Charan20510/sign_lang_hud_glasses/docs/handoff/00_project_overview.md

# Project Handoff — Sign-Language → Smart-Glasses HUD (Semester Project)

> Project overview (stable facts). Day-by-day notes live in `YYYY-MM-DD.md` next to this file.
> Paste this whole file into a new chat with: "Continue my project from this handoff. Next I want to: ____"

## 1. Project in one line
ISL signer in front of me → camera → **laptop** (MediaPipe + PyTorch) recognises the sign → word sent over **Wi-Fi** → **ESP32-C3** on my glasses shows it on a **0.96" OLED**, reflected into my eye (DIY HUD). Combined CS + ECE project.

- Me: Charan, final-year B.Tech ECE (VLSI), IIIT Senapati, Manipur. Dev machine: MacBook Air (Apple Silicon).
- **Ownership (from 2026-10-31):** Charan = hardware + firmware (branch `testout`); friend = all software (branch `S1`). Shared contract: `docs/interface.md`.
- **Since 2026-11-01:** friend's app imported into `software/` on branch `software` (from github.com/integral-830/sign-inference-bridge); it sends every word + sentence to the glasses over UDP.
- Style: short, simple key points.
- Scope: **isolated words** (INCLUDE-50 + my own words), not full sentences.

## 2. Final architecture
```
[Camera: laptop webcam (now) / ESP32-CAM on glasses (stretch)]
   → [Laptop: software/run.py — MediaPipe landmarks → TCN model → sentence builder → (English)]
   → UDP JSON {"text","conf"} to glasses.local:4210 over phone hotspot (software/glasses.py)
   → [ESP32-C3 SuperMini + SSD1306 OLED (firmware/glasses_display) → 25mm lens → 45° acrylic → eye]
```

## 3. Optics design (side view, cm, internal) — drawn in hud_glasses_drawings.pdf
- **Update 2026-10-31 (enclosure v3.1):** mirror dropped; OLED sits 22 mm from the lens (bench value, ±3 mm focus slots). Numbers below are the original design.
- OLED → mirror (45°): **2.2** | mirror → lens: **1.8** | total u = **4.0 cm** < f = 4.5 cm
- Lens → acrylic (45°): **1.5** | eye relief ≈ **2.0**
- Result: virtual image ≈ 36–38 cm away, ~9× magnified.
- Housing: total length **9.5**, optics head **2.5**, electronics tube **7.0**, height **3.0**, internal width **2.9**, head drops to **6.0**.
- Panels: side ×2 (L-shape 9.5×6.0), top 9.5×2.9, bottom 7.0×2.9, front 3.3×2.9, rear 3.0×2.9 (2 USB-C cut-outs 0.9×0.35), lens plate 2.5×2.9 (hole Ø2.4), mirror 2.5×2.9, acrylic 3.0×2.9, step strip 0.3×2.9.
- Notes: paint interior matte black; thin acrylic (1 mm) avoids double image; text may be flipped → fix in code (setRotation / mirror commands); focus by sliding OLED ±3 mm.
- Based on github.com/perseus784/June_Glasses (concept/optics only; its electronics had flaws: no regulator, ESP8266-01, hardcoded IP).

## 4. Electronics & wiring
**Display unit (glasses):**
- LiPo #1 → TP4056 #1 (B+/B−) → OUT+ → slide switch → ESP32-C3 **5V** pin; OUT− → GND
- ESP32-C3 → OLED: 3V3→VCC, GND→GND, **GPIO8→SDA, GPIO9→SCL**, I2C addr 0x3C

**Camera unit (stretch, opposite arm):**
- LiPo #2 → TP4056 #2 → switch → **MT3608 set to 5.0 V** → ESP32-CAM 5V/GND
- Never feed LiPo directly to ESP32-CAM. Runs hot; ~1 h on 600 mAh.

**Safety / charging (decided 2026-10-29):** TP4056 left stock (1 A = 1.7C for 600 mAh) → its USB is NEVER used with a cell attached (port taped "NO USB"). Charge only with the lab bench supply: 4.20 V CV, 0.30 A limit, stop at ≤ 0.05 A. Battery leads soldered to B+/B−, never hand-held.

## 5. Parts status (as of 24 Oct 2026)
**In hand (Robocraze order 377900, delivered):** ESP32-C3 SuperMini ×2 (unsoldered), 0.96" SSD1306 OLED ×2,
TP4056 Type-C w/ protection ×2, slide switch ×3, veroboard 6×4 ×2, 40×2 male + 40×1 female berg,
Type-C cable, MB102 830 breadboard, jumper wire set, 12-in-1 soldering kit (with multimeter).

**Arrived by 2026-10-29:** LiPo 3.7 V **600 mAh** ×2 (KP 602030P, ~30 × 20 × 6 mm), DOMO 25 mm / f45 lens pair, 1 mm acrylic ×4.
**Still to get:** mirror 25 × 30 mm (local shop), heat-shrink/tape.
**Stretch, not ordered yet:** ESP32-CAM OV3660, ESP32-CAM-MB, MT3608 boost, glue gun.

**Local / already have:**
- Mirror piece 2.5×2.9 cm — local glass shop (₹10–30), thin glass preferred
- Glasses frame — my Lenskart computer glasses (mount with zip ties/velcro, no glue; raise OLED contrast because of blue-cut coating)

## 6. Software (`software/`, branch `software`; friend's code)
- `python software/run.py --port 9000` → camera + model + HTTP server (phone) + **UDP to the glasses (default)**.
  `--glasses <IP>` if `glasses.local` fails, `--no-glasses` to turn it off, `--simulate` = fake signer (no camera/model).
- `software/glasses.py` = UDP sender (`{"text","conf"}`, < 256 bytes, host/port from `config.yaml`); self-check: `python software/glasses.py`.
- Live run sends each signed word, each spelled word, then the finished sentence (English if `--translate`).
- Model: `software/model/sign_model.pt` (words, TCN). Training/datasets: `software/RUNBOOK.md`.
- Root `venv/` has torch, mediapipe, opencv, numpy, pyyaml. Camera preview: 1280×720 + preview-only white balance.
- Step-by-step: `docs/run_guide.md`. Manual link test: `tools/send_test.py`.

## 7. Files created so far
- `CLAUDE.md` — Claude Code project spec (hardware side, rules; gitignored)
- `docs/interface.md` — app ↔ glasses contract
- `docs/run_guide.md` — flash → link test → simulate → live camera
- `firmware/glasses_display/glasses_display.ino` — final receiver: centred size-2 words; sentence scrolls 2× (60 px/s) then blank
- `software/` — recognizer app (run.py, live_demo.py, glasses.py, RUNBOOK.md)
- `hud_glasses_drawings.pdf` + 2 PNGs — side view with dimensions, optics math, wiring diagram, cut templates

## 8. Open to-dos
1. Hardware bring-up (`docs/hardware_bringup.md`): Steps 1–11 ✅ (2026-10-31). Next: 12 optics bench + measurements → 13 soldering → 14 enclosure print (`hardware/enclosure`).
2. LiPos: charge only on the bench supply (4.20 V, 0.30 A, stop ≤ 0.05 A).
3. glasses_display: NO LINK after 10 s + Wi-Fi auto-reconnect.
4. Latency measurement (packet in → OLED update) for the report.
5. Tell friend about `software/`; agree any packet change via `docs/interface.md`; decide when to merge `software` → `testout`/`main`.
6. Later: camera unit (ESP32-CAM), report & viva prep.

Daily log: see `docs/handoff/README.md`.
