Charan20510/sign_lang_hud_glasses/docs/handoff/2026-11-01.md

# 2026-11-01

Branch: `software` (on top of `testout`). Pushed to GitHub: `software` → `origin/main`, plus `testout`.

## Done
- **Run guide** `docs/run_guide.md`: flash glasses_display → `send_test.py` → `run.py --simulate` → live camera, + troubleshooting.
- **Link works end to end:** `send_test.py` → glasses at 10.249.236.231; `run.py --simulate --port 9000` → words + sentences on the OLED.
- **Final receiver** `firmware/glasses_display/glasses_display.ino` (from t4 Wi-Fi/UDP + t6 centring):
  - word that fits (≤ 10 chars) → centred, text size 2;
  - longer text (sentence) → one line, size 2, scrolls right-to-left at `SCROLL_PX_PER_S` 60, `SCROLL_PASSES` 2 times, then blank;
  - `MIRROR_X` / `FLIP_Y` = 0; `secrets.h` copied from t4 (gitignored). Compiles: 79 % flash.
- **Simulation** (`run.py --simulate`): English words one by one, `WORD_GAP_S` 2 s apart, then the sentence;
  waits `SCROLL_PASSES × scroll_seconds()` so both passes finish (measured 14.6 s gap for "I am going to school.").
- **Live camera run works** with `software/model/sign_model.pt` (words model, TCN); venv now has torch 2.15, mediapipe 0.10.35, opencv 4.11.
- **Camera preview:** opens at 1280×720 (was 640×480, blurry); preview-only gray-world `white_balance()` removes the yellow cast of the warm room light (recognition uses the raw frame).
- **Rosetta 2 installed:** Arduino's `ctags` is x86_64 → "bad CPU type in executable" fixed.
- **Root `README.md`:** how it works, status, BOM, wiring, enclosure gallery + STL links, step-by-step setup,
  interface, config, troubleshooting, layout, credits (friend's software → integral-830/sign-inference-bridge).
  New images in `docs/images/`: `system.svg`, `wiring.svg`, `assembly_eye_side.png` (OpenSCAD inside view).
  `<!-- PHOTO: ... -->` slots mark where real photos go.
- **Pushed to GitHub** (github.com/Charan20510/sign_lang_hud_glasses, public): `software` → `main` (fast-forward), `testout`.
  Secret scan first: no `secrets.h`, `.env`, keys or the real hotspot name/password in any commit. `S1` not pushed.

- **Project report** `docs/report/main.tex` (+ `main.pdf`, 32 pages) in the IIIT Manipur B.Tech template:
  US Letter, 0.8/1 in margins, Times New Roman 12 pt, template header + `Page N` footer, same page order and
  all 7 chapters / 30 sections (checked by script). Figures: TikZ (system, optics, workflow, wiring, firmware
  flowchart, scroll-time graph) + OpenSCAD renders; logo cropped from the template PDF. Placeholders left for
  name, roll no, advisor, month/year (`\newcommand`s at the top). Build: `cd docs/report && tectonic main.tex`.

- **Report restructured as a group project** (`docs/report/main.tex`, 36 pages): Ayush Verma (230102017) +
  Charan Tej (230104002), supervisor Dr. B. Somaraju, Project II (EC4201), 7th sem, Nov 2026. Format now follows
  the department's Major Project Report (A4, 1.5 spacing, roman front matter, CHAPTER N, 5 chapters + Appendices A-D,
  abbreviations + symbols lists). All internship text removed (0 hits). Change log: `docs/report/report_changes.pdf`
  (Space Mono 12px, from `changes.html`, built by `docs/guide/build_pdf.sh`).

- **README engineering drawings:** 6 hand-drawn-style SVG sheets in `docs/images/drawings/` (side view to scale,
  optics ray diagram, wiring, clip mount, printed parts, OLED screens) from `make_drawings.py`; values from
  `hud_enclosure.scad` + its echo, STL bounding boxes, bench measurements. Old concept sheets kept as
  `docs/drawings/hud_glasses_drawings_v1.pdf` (superseded). README: new section + sheets under How it works / Wiring.

## Issues
- `glasses.local` (mDNS) sometimes not found from the Mac → use `--glasses 10.249.236.231` (IP shown on the OLED).
- Port 8000 is held by the HUNT project's uvicorn → run with `--port 9000`.
- glasses_display has no NO LINK screen or Wi-Fi auto-reconnect yet (CLAUDE.md §5 asks for both).
- Simulation shows English words; the live run shows only signed glosses (ISL has no sign for "is", so TODAY HOT ≠ IT IS HOT TODAY).
- git `user.name` is set to `--all` → commits use `git -c user.name=Charan20510`.

## Fixes
- Sim used ISL glosses (only TODAY / HOT appeared) → sim now splits the English sentence into words.
- Cramped 4-line word-wrap for sentences → replaced by a one-line scroll; `wrap()` removed.
- `download_models.py` must run from `software/` so models land in `software/mp_models/`.

## Next
- glasses_display: NO LINK after 10 s without a packet (keep last text?) + Wi-Fi auto-reconnect.
- Measure glasses-side latency (packet in → OLED update) for the report.
- Tell the friend the app now lives in `software/` (their HTTP/phone path is untouched; `esp/` sketches dropped).
- `main` now equals `software`; decide whether `testout` should catch up too.
- Take photos (breadboard, soldered unit, printed enclosure, glasses worn) → `docs/images/`, replace the README `PHOTO` comments.
- Report: confirm course code EC4201, date and work division (Ayush = software); add real photos (commented slots in ch. 4).
- Tell the friend their code is public in this repo (credited in the README).
- Hardware: Step 12 optics bench + measurements → enclosure print.

## Commits
- 00:07 `8c8613a` Add run guide: app to ESP32 Wi-Fi to OLED
- 00:21 `e57b8ba` glasses_display: centred size-2 words; simulate English words 2 s apart
- 10:54 `074ead4` glasses_display: scroll the full sentence horizontally; sim waits one pass
- 11:21 `8340ac4` Camera preview: 720p capture and preview-only white balance
- 12:05 `82cfd81` glasses_display: scroll sentence 2 times then blank screen
- 12:16 `d227a04` Handoff: sync day logs and project overview to end of 2026-11-01
- 12:25 `1893378` Add t6_mirror_center test sketch; handoff log entry
- 12:29 `06ae0ae` README: project overview, diagrams, enclosure renders, setup guide
- 12:29 `b407f08` Handoff: README and GitHub push notes
- 12:30 `4ead668` Handoff: branch line and commit log
- 12:54 `adc36bd` Project report in LaTeX (IIIT Manipur template) with figures
- 12:54 `e27fc8e` Handoff: project report notes
- 13:26 `35e1088` Report: restructure as group project (Project II, EC4201) + Space Mono change log
