Charan20510/sign_lang_hud_glasses/docs/handoff/2026-10-31.md

# 2026-10-31

Branch: testout

## Done
- Bring-up Steps 1–11 all done (Charan): guide stamps ✅ on Steps 7–11, checklist rows ticked, `docs/hardware_bringup.md` Results rows 1–16 ✅ (readings not recorded).
- Step 12 fill-in sheet: `docs/step12_measure.pdf` (2 pages, source `docs/guide/step12_measure.html`, built by `build_pdf.sh`).
- Bench result: OLED → lens **22 mm** is sharp (design had 40 mm with f = 45); lens → acrylic 34 mm worked, model keeps 16 mm.
- **Enclosure v3** (`hardware/enclosure/hud_enclosure.scad`): mirror removed; OLED lies flat, screen down, 22 mm above the lens, held by side-wall rails (glass-free strips only) with slots at u = 19 / 22 / 25; head 30 mm long; lens plate moved to 6 mm below the tube floor (eye 21 mm below the tube); new `section` preview. Pockets, lid clicks, fingers, dovetail + clip kept. All parts render clean, asserts pass.
- README rewritten for v3 with step-by-step "how to view the 3D model" (OpenSCAD Customizer `part`, F5/F6, mouse, views, Quick Look).
- Step 12 in guide, md and the fill-in sheet switched to the no-mirror path (u = 22, focus check O5). PDFs rebuilt.
- Glasses measured: temple arm 7 × 7, dv = +10, dh = 37, rim = 13.
- **Enclosure v3.1 (print-ready):** lens → acrylic **25 mm** (`drop` 43, eye 30 mm below tube); glasses entered as raw values (`temple_w/h`, `temple_dv`, `temple_dh`, `frame_rim`) and clip derived (jaw_drop 35, jaw_out 12.5, strain 2.2 % with `jaw_lip` 0.45); rim clears tube by 14.6; new `plate` part → `stl/print_all.stl` (all 4 parts on one bed, 137 × 161 mm). Step 12 docs + sheet updated (25 mm, raw values).
- Print estimate: ~73 g PLA, ~6 h normal / ~2.5 h fast printer (body 50 g, lid 16, clip 5, lens plate 2); `test_fit` optional 27 g.

- **Re-scope to hardware only:** software is my friend's part (branch `S1`). On `testout` removed `ml/`, `app/`, `tools/record_custom.py`, `tools/data_summary.py`, `tests/test_normalize.py`, `reports/`, and the obsolete mirror order sheet (`docs/mirror_order.*`, `docs/guide/mirror_order.html`). `config.yaml` trimmed to `network:`; `requirements.txt` → `pyyaml`, `pytest`; `data.zip` gitignored.
- Cleanup (local only, to Trash): all `.DS_Store`, `files/PROJECT_HANDOFF.md` (old overview duplicate), `.pytest_cache/`, old 1.4 GB `venv/`. Rebuilt `venv/` with only `pyyaml` + `pytest` (42 MB).
- Removed `tests/test_send_test.py` and `pytest` (not needed for hardware). Kept `config.yaml` (read by `send_test.py`) and `scripts/` (post-commit hook fills the Commits list).
- New `docs/interface.md`: UDP 4210, `{"text","conf"}` JSON < 256 bytes, `glasses.local`, NO LINK 10 s. CLAUDE.md rewritten for the hardware side; overview §1/§6 updated.
- Branch `software` (off testout): friend's app imported into `software/` (no esp/, no .git). `software/glasses.py` sends each word + sentence over UDP to glasses.local:4210; `run.py` does it by default. Verified: self-check OK, `run.py --simulate --glasses 127.0.0.1` → packets ME / SCHOOL / GO / "I am going to school."
- `~/Downloads/sign-inference-bridge` moved to Trash (git was clean + pushed to integral-830/sign-inference-bridge).

## Issues
- Step 7–11 readings (B+ volts, runtime hours, …) not written down; only ✅.
- u = 22 doesn't match the lens's marked f = 45 (theory → image ~10 cm from the eye). Real f probably ~25 mm.
- Mirror no longer used; `docs/mirror_order.*` sheet is obsolete (removed in the re-scope).
- `CLAUDE.md` is gitignored, so its rewrite stays local only.
- `data.zip` (12 GB) and `data/` (12 GB) were the friend's ML data; friend has a copy, both moved to macOS Trash (empty Trash to free ~24 GB).
- Glasses show NO LINK after 10 s idle: the app sends only when a word/sentence happens (no keep-alive in the contract).
- Full live run (camera + model) not tested here: root venv has only pyyaml; needs `pip install -r software/requirements.txt` + trained model.

## Fixes
- Design follows the bench value (`d_oled_lens = 22`) with ±3 mm focus slots instead of f = 45 math.
- OLED PCB (27.3) is narrower than the 29 mm inside → rails reach in 2.5 mm and grip only the glass-free front/rear strips.

## Next
- Print `hardware/enclosure/stl/print_all.stl` (black PLA, 0.2 mm, 3 walls, 20 %, no supports); optional `test_fit.stl` first.
- Still unmeasured (defaults): board sizes, OLED glass start/end (`oled_glass_x`), lens thickness, lens real f.
- Bend OLED header pins flat toward the rear (3.5 mm room above the PCB) or solder wires directly.
- Uncommitted: enclosure v2→v3.1, Step 12 sheet, mirror order sheet, `t3_oled_hello` MIRROR_X 0.
- `firmware/glasses_display/` is still empty; write the receiver, then `python software/run.py --simulate` against real glasses.
- Tell friend the app now lives in `software/` (their HTTP/ESP path untouched; `esp/` sketches dropped).

## Commits
- 14:46 `943764b` Enclosure v3.1: no mirror, measured glasses, print-ready plate
- 16:07 `1fc3abe` Re-scope repo to hardware/firmware; software moved to friend (S1)
- 16:10 `02a4b76` Handoff: dataset removed from laptop (friend has copy)
- 17:38 `63a4b4e` Handoff: local cleanup, small venv
- 17:41 `2aa1bf3` Remove packet test and pytest; keep config + hooks
- 23:55 `0ecd47a` Import recognizer app into software/ and send words to glasses over UDP
