Charan20510/sign_lang_hud_glasses/docs/handoff/2026-10-30.md

# 2026-10-30

Branch: testout

## Done
- Enclosure v2 built (`hardware/enclosure/hud_enclosure.scad`):
  - pockets for LiPo, TP4056, ESP32-C3 and the switch, with engraved labels;
  - lid clicks shut with 3 bumps, and 2 lid fingers hold the boards down;
  - `side = "right"`, which mirrors the parts for the right eye;
  - female dovetail slot in the temple-side wall (now 4 mm thick) + new swappable `clip` part that snaps onto the temple arm.
- `lipo` set to the real 600 mAh 602030 (30 × 20 × 6). TP4056 USB-C hole replaced by a Ø3.5 charge-lead exit (bench-supply charging).
- `build.sh` exports body, lid, lens_plate, clip and test_fit: all clean, all asserts pass. README rewritten for v2.

## Issues
- Planned snap hooks for the boards would crack: 1.2 × ~3.5 mm cantilever, 0.5 mm bend ≈ 7 % strain vs PLA ~2–3 %. Board edges also carry pins and pads.
- Possible frame clash: tube floor is ~15 mm above the acrylic centre; a tall glasses rim may hit it.

## Fixes
- Boards held by 3-sided pockets + lid fingers on the USB-C shells instead of hooks.
- Clip jaw sized by a strain check (`jaw_t` 1.6, `jaw_lip` 0.5 → 1.9 %); the render fails above 2.5 %.

## Next
- Measure the temple arm (`temple_w`, `temple_h`, `jaw_out`, `jaw_drop`), plus the boards, switch and mirror. Update the `MEASURE` variables → `sh hardware/enclosure/build.sh`.
- Print `test_fit.stl`: tune `clr`, `dt_clr` and `jaw_grip`. Hold the clip on the glasses to check the frame-rim clearance.
- Then print body, lid, lens plate and clip in matte black.
- Bring-up: insulate battery joints, tape the TP4056 USB, Step 7 USB-only test, Step 11 leftovers.

## Commits
- 14:55 `f70fc3c` Bring-up: Step 10 runs on battery (READY + IP, 5V pin 3.967 V)
