Charan20510/sign_lang_hud_glasses/docs/handoff/2026-10-29.md

# 2026-10-29

Branch: testout

## Done
- 3D-printed enclosure for the display unit: `hardware/enclosure/hud_enclosure.scad` (OpenSCAD, parametric) + `build.sh`.
- Exported `stl/body.stl`, `lid.stl`, `lens_plate.stl`, `test_fit.stl` + PNG previews; README with cut list, print settings, assembly.
- Installed OpenSCAD (`brew install --cask openscad@snapshot`; stable cask is disabled by Homebrew).
- Planned enclosure v2 (snug pockets + clip-on mount); not built yet, plan below.

## Issues
- Drawing's lens→acrylic 15 mm makes the 30 mm acrylic hit the lens plate.

## Fixes
- Lens→acrylic set to 16 mm (`d_lens_acr`); focus depends only on u = 40 mm, unchanged.

## Next — enclosure v2 (pockets + clip-on)
Resume: say "continue enclosure v2 from today's handoff".
Choices made: swappable clip on a dovetail, snug pockets + snap hooks, right eye.
Files: `hardware/enclosure/hud_enclosure.scad`, `build.sh`, `README.md`. Reuse `box()`, `usb_cut()`, asserts, part selector.

0. **Measure first:** temple arm width × height where the clip goes (`temple_w`, `temple_h`); LiPo, TP4056, ESP32-C3, OLED, mirror thickness.
1. **Right-eye side fix:** wearer's right = +y = lid side in v1, but the body wall must face the temple.
   Add `side = "right"`; wrap body/lid/lens_plate in `mirror([0,1,0])` when right; counter-mirror labels so text reads.
2. **Pockets (replace bare shelves + foam tape):**
   - LiPo floor cradle: rim walls 1.2 thick × 4 high on the front and lid side; the TP tray above caps it.
   - TP4056 + ESP32 trays: 3-side rim 1.0 high (front stop, body side, rear = wall). The lid-side edge gets a snap hook
     (cantilever 1.2 thick, 0.5 overhang, 45° lead-in); press the board down and it clicks under the hook.
   - Raise ESP tray: `s2 = s1 + shelf_t + tp_h + 3.0` (room to press the TP4056 past its hook).
   - Switch: press-fit cradle under the top slot (`sw_body = [8.6, 3.6, 3.6]`, 0.1 interference).
   - Labels cut 0.4 deep, 3 mm font: LiPo, TP4056, ESP32, SW. OLED comb unchanged; keep the wire gap on the lid side.
3. **Lid without zip ties:** 0.4 bumps on the lid lip bars, 0.6 dimples in the body walls → clicks shut. `tie_grooves_on = false` by default.
4. **Clip-on mount:**
   - Body side wall `side_t = 4` (was 2.4), body only.
   - Female dovetail slot in the outer face of the body side wall, along x on the tube (x 50..80, mid-height):
     mouth 6, inner 9, depth 2.5, open at the rear end, stop at the front end, 0.4 detent bump. Prints fine on the bed face (27° walls, 9 mm bridge).
   - New part `clip` = `linear_extrude(25)` of one 2D profile (prints on its side, no supports):
     male dovetail (−0.2 clearance) → arm (`jaw_drop`, `jaw_out`) → C-jaw around `temple_w × temple_h`,
     wall 2, bottom opening with 0.8 lips, 0.3 interference grip, dimple for the detent.
   - New glasses = change `temple_w/temple_h` (+ `jaw_drop/jaw_out`), reprint only `clip.stl` (~10 min).
5. **Checks / outputs:**
   - Asserts: pockets inside the cavity, hooks clear of the lid lip, slot depth < `side_t` − 1, slot clear of the USB/switch cut-outs, jaw opening < `temple_w`, ESP USB-C pocket ≤ H.
   - `test_fit`: add the TP tray with hook, a 30 mm slot segment, and the clip. `build.sh`: add `clip` to the part loop.
   - README: measure the temple, swap-clip steps, new assembly order (no tape or ties). Update the handoff log.
   - Done = `sh hardware/enclosure/build.sh` runs clean, previews show pockets, slot and clip. Don't change optics distances/comb, firmware or ml. Don't commit unless asked.

Still open from v1: get the mirror cut to 25 × 30 mm and the acrylic to 30 × 30 mm; print `test_fit.stl` at the college lab and tune `clr`.

## Bring-up (Step 7)
### Done
- LiPo ×2 (600 mAh, KP 602030P), 25 mm lens and 1 mm acrylic arrived.
- Rewrote the bring-up guide to 15 steps (`docs/guide/bringup.html` → `docs/hardware_bringup.pdf`, 17 pages; `docs/hardware_bringup.md` matched):
  7 chargers USB-only, 8 R3 mod (new), 9 battery leads + first charge (new), 10 ESP32 on battery + runtime (new),
  11 leftover checks, 12 optics bench test (new), 13 soldering, 14 enclosure, 15 checklist (synced with md results).

### Issues
- Step 7: LiPo put on TP4056 #1 with wires held by hand; red LED = charging at ~1 A (R3 still stock 1.2 kΩ = 1.7C for 600 mAh).
- Cells are 600 mAh / ~30 × 20 × 6 mm, not the planned 500 mAh / 35 × 26 × 7 (`lipo` size in `hardware/enclosure/README.md` + scad is stale).

### Fixes
- Told to unplug, remove the cell, check it for heat/swelling. Guide now blocks any LiPo until the R3 mod (Step 8) and requires soldered leads (Step 9).

### Next
- Step 7 USB-only B+ readings + switch beeps → buy 2.2–2.4 kΩ ×2 → Step 8 R3 mod → Step 9.
- Optics Step 12 can start now without the mirror (lens + acrylic only).
- Enclosure v2: update the `lipo` pocket to the real cell size (measure it).

## Bring-up (charging decision)
### Done
- LiPo #1 measured 3.999 V (Rigol DM3058E) → ~80 %, no charge needed now.
- Decision: no R3 mod, no new charger. Charge on the lab bench supply (4.20 V CV, 0.30 A limit, stop ≤ 0.05 A). TP4056 stays stock, its USB is taped "NO USB" once a cell is soldered.
- Guide updated: Step 8 = bench-supply charging (R3 mod kept as an optional note), Step 9 = solder leads + NO-USB tape, Step 10 wake/recharge via bench supply, checklist rows 11–16. PDF rebuilt (17 pages), md matched.

### Next
- Step 7 (TP4056 USB-only B+ test, no battery, + switch beeps) → Step 9 (solder LiPo, tape USB) → Step 10 (ESP32 on battery + runtime).
- Charge only when a cell drops to ~3.5–3.9 V.

## Bring-up (Step 10 on battery)
### Done
- Battery → TP4056 B+/B− → OUT+ → slide switch → ESP32-C3 5V, OUT− → G. OLED showed `READY` + 10.249.236.231 on battery; words from `send_test.py` appeared.
- 5V pin = 3.967 V under load (battery was 3.999 V unloaded) — expected, the 5V pin is the battery voltage on battery.
- Slide switch: 2 end tabs are mounting only (noted in the guide).

### Issues
- Battery-to-extension-wire joints are bare (short risk). Dim red LED on the TP4056 with no USB (leakage, harmless).

### Next
- Insulate the battery joints, tape the TP4056 USB "NO USB".
- Measure ESP32 3V3 (≈ 3.3 V), switch OFF/ON test, runtime test.
- Step 7 USB-only B+ test (no battery), then Step 11 leftovers.

## Commits
- 13:28 `c196fae` Enclosure: parametric OpenSCAD model, STLs, print + assembly guide
- 13:48 `cbd6379` Handoff: enclosure v2 plan (pockets + clip-on mount)
- 18:29 `76ddb17` Bring-up guide: 15 steps, bench-supply LiPo charging
