Charan20510/sign_lang_hud_glasses/docs/handoff/2026-10-26.md

# 2026-10-26

Branch: testout

## Done
- Logged bring-up results Steps 3–6 (see 2026-10-25); docs, CLAUDE.md tips and memory updated.

## Issues

## Fixes

## Next
- Step 6 extras: `python tools/send_test.py --text hello` (glasses.local) and `echo -n "hi" | nc -u -w1 <IP> 4210`.
- Step 7: TP4056 #1/#2 B+ ≈ 4.2 V on USB only; slide switches ×3 continuity.
- TP4056 R3 mod (~2.4 kΩ) BEFORE any LiPo.
- ESP32-C3 #2 blink, OLED #2 scan + HELLO, MIRROR_X test.

## Commits
- 16:59 `310b429` Bring-up: steps 3–6 results, docs update
