Charan20510/sign_lang_hud_glasses/docs/handoff/2026-10-24.md

# 2026-10-24

Branch: testout

## Done
- Robocraze order received + breadboard, soldering kit, jumper wires (see overview §5).
- Committed `.gitkeep` cleanup on S1; created branch `testout` for hardware bring-up.
- Moved handoff from `files/` (gitignored) to tracked `docs/handoff/`; dated daily log + post-commit hook.
- Wrote `docs/hardware_bringup.md`, test sketches in `firmware/tests/`, `tools/send_test.py`.
- Step 1 ✅ both ESP32-C3: 5V pin = 5.162 V, 3V3 pin = 3.302 V (Rigol DM3058E bench meter).
- Decision: no soldering until final build; all tests on breadboard with friction-fit headers. Guide Step 2 rewritten, soldering moved to "Final build" section.
- Made printable guide `docs/hardware_bringup.pdf` (11 pages, A4, Space Mono 12px, drawn SVG diagram per step) from `docs/guide/bringup.html` via Chrome headless.

## Issues
- Global git `user.name` is `--all` (broken). Commits made with `git -c user.name=Charan20510`.
- `arduino-cli` not installed yet.
- Meter read ~0 V (red lead in the 10A jack).
- PDF symbols (✅ ☐ ⚠ →) render in Menlo: Space Mono has no such glyphs. Text itself is Space Mono.

## Fixes
- Meter: red lead moved to Input HI (VΩ) jack → correct volts.
- Fix git name: `git config --global user.name "Charan20510"`.

## Next
- Bring-up Step 2 (friction-fit) → Step 7 (`docs/hardware_bringup.md`), record pass/fail.
- Solder headers at final build.

## Commits
- 87fed89 (S1) Remove .gitkeep placeholders
- 12:19 `28232c6` Hardware bring-up: test sketches, send_test.py, dated handoff log
- 13:16 `9f26e50` Bring-up: breadboard-only Step 2 (friction-fit), soldering moved to final build
- 13:39 `7e3b40d` Bring-up: printable PDF guide with step diagrams
