Charan20510/sign_lang_hud_glasses/docs/handoff/2026-10-25.md

# 2026-10-25

Branch: testout

## Done
- Step 3: t1_blink uploaded, blue LED blinks (/dev/cu.usbmodem11201).
- Step 4 ✅: I2C scan `found device at 0x3C` after wiring fix; OLED shows text; own `t5_icons` sketch shows an image2cpp bitmap.
- Step 5 ✅: `secrets.h` created; board on hotspot at 10.249.236.231.
- Step 6 ✅: `python tools/send_test.py --host 10.249.236.231 --text hello` → word on OLED.

## Issues
- t2_i2c_scan.ino got two file paths pasted into it (files dragged into the editor) → `expected unqualified-id before '/' token`; then the t2 folder vanished when the IDE window closed.
- OLED labels pins `SCK`/`VDD` instead of `SCL`/`VCC` (same pins).
- `python` not found / `No module named 'yaml'` with venv "active": venv was created at `~/Desktop/sign_lang_hud_glasses`, project moved to `~/projects/`, so `venv/bin/activate` pointed at a folder that no longer exists.

## Fixes
- Restored t2 sketch with `git restore`. Open sketches via File → Open, never drag into the code area.
- SCK = SCL → GPIO9, VDD = VCC → 3V3.
- Rewrote the old path in `venv/bin/*` (activate + script shebangs) to `~/projects/...`. Re-activate: `deactivate; source venv/bin/activate`.
- t4: removed the "from <IP>" line under each received word (only the word shows now; boot screen still shows READY + IP).

## Next
- Step 7: TP4056 + slide switches (USB only), R3 mod before LiPo.
- Board #2 blink, OLED #2, mirror test, `glasses.local`.

## Commits
