Charan20510/sign_lang_hud_glasses/hardware/enclosure/stl/lid.stl

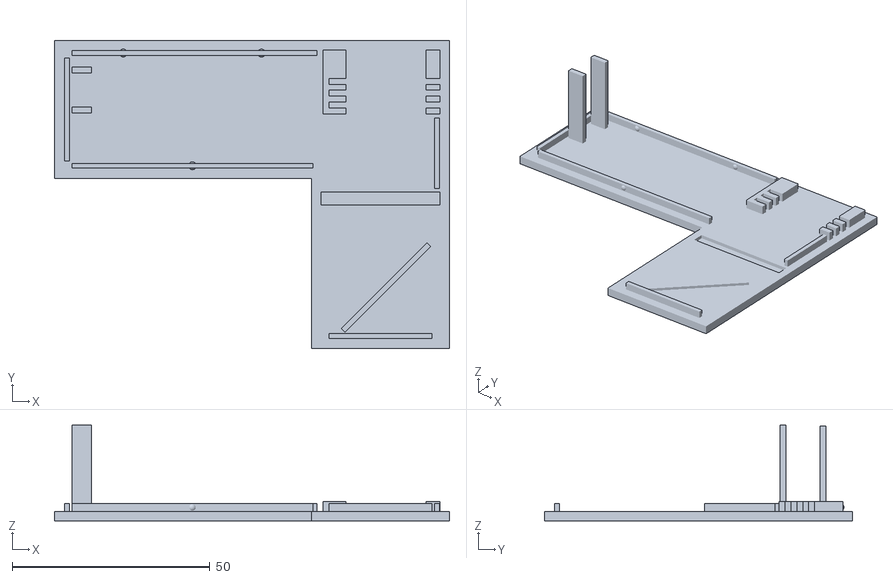
[picture p15: CAD file, 2026-10-31]
hardware/enclosure/stl/lid.stl
99.8 x 77.8 x 24.1
