Charan20510/sign_lang_hud_glasses/hardware/enclosure/stl/lens_plate.stl

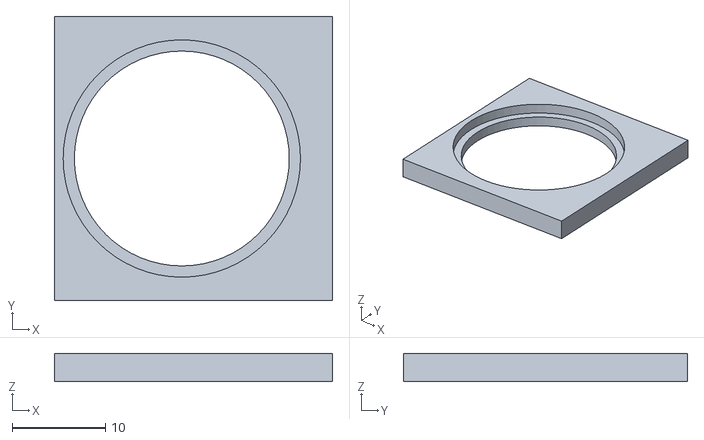
[picture p16: CAD file, 2026-10-31]
hardware/enclosure/stl/lens_plate.stl
29.8 x 30.4 x 3.00
