Charan20510/sign_lang_hud_glasses/hardware/enclosure/stl/print_all.stl

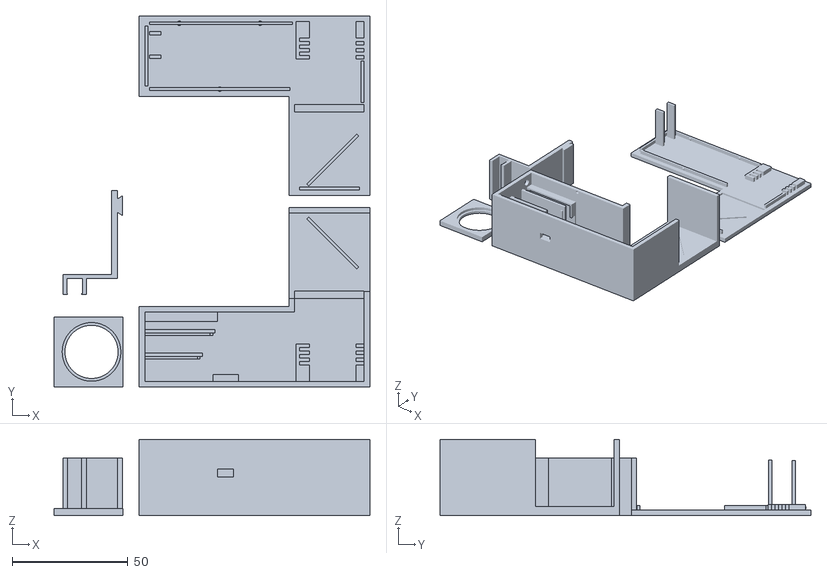
[picture p17: CAD file, 2026-10-31]
hardware/enclosure/stl/print_all.stl
136.6 x 160.6 x 33.0
