Charan20510/sign_lang_hud_glasses/hardware/enclosure/stl/body.stl

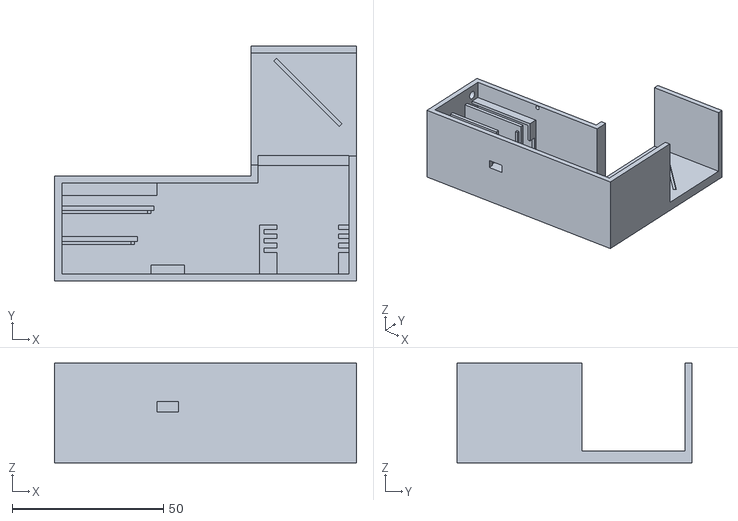
[picture p18: CAD file, 2026-10-31]
hardware/enclosure/stl/body.stl
99.8 x 77.8 x 33.0
