Charan20510/sign_lang_hud_glasses/hardware/enclosure/stl/test_fit.stl

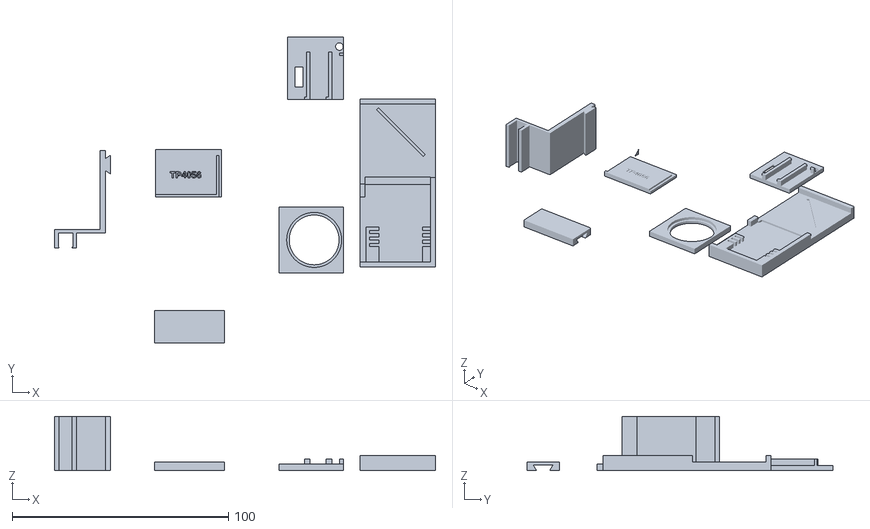
[picture p19: CAD file, 2026-10-31]
hardware/enclosure/stl/test_fit.stl
176.0 x 141.5 x 25.0
