Charan20510/sign_lang_hud_glasses/hardware/enclosure/stl/clip.stl

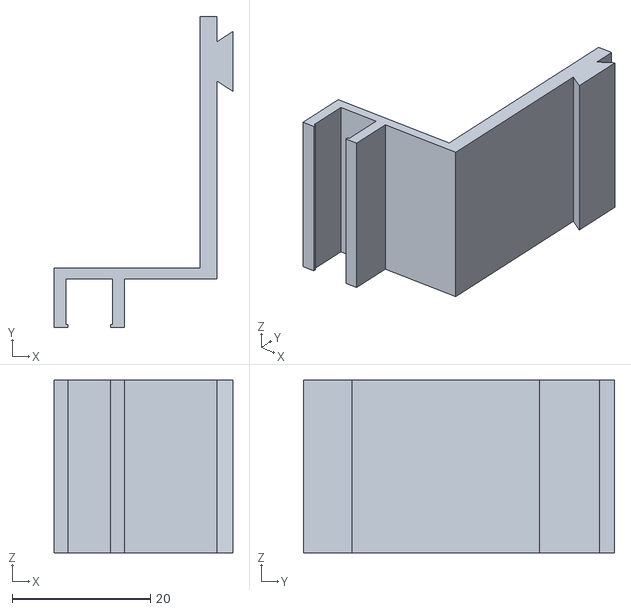
[picture p20: CAD file, 2026-10-31]
hardware/enclosure/stl/clip.stl
25.9 x 45.0 x 25.0
