Charan20510/sign_lang_hud_glasses/docs/report/changes.html

# Project Report: Change Log

File: docs/report/main.tex → main.pdf · 32 → 36 pages

## 1. Identity details

Item | Before | After
Report type | Internship report | Group project report
Students | [STUDENT NAME], [ROLL NUMBER] | Ayush Verma (230102017), Charan Tej (230104002)
Supervisor | [FACULTY ADVISOR] | Dr. B. Somaraju, Assistant Professor, Department of ECE (email somaraju@iiitmanipur.ac.in)
Course | none | Project II (EC4201), 7th Semester
Date | [MONTH, YEAR] | November, 2026; Place: Senapati, Manipur
Voice | "I / my" | "we / our" throughout

## 2. Internship items removed

- "Internship Documents" page: removed.
- Running header "B.Tech Internship Report | Department of ECE | IIIT Senapati, Manipur": removed.
- Declaration and certificate text "during the internship at [ORGANIZATION NAME]": replaced by the department's project wording.
- Section 1.2 "Internship Overview" and 1.6 "Scope of the Internship": replaced by project sections.
- The organization "(in-house project)" line: removed.
- Check: the word "internship" appears 0 times in main.tex and in the PDF text.

## 3. Page format

Item | Before (IIIT template) | After (Major Project Report)
Paper | US Letter, margins 0.8 in / 1 in | A4, 1 in all round
Font | Times New Roman 12 pt | Default LaTeX font (Computer Modern) 12 pt
Line spacing | Single | 1.5 (title page single)
Header | Template text on every page | None
Footer | "Page N" | Page number only, centred
Page numbers | Arabic from the cover | No number on the title page; roman (i, ii, ...) for the front matter; arabic from Chapter 1
Chapter title | "Chapter N" + title, right-aligned | "CHAPTER N" + UPPERCASE title, centred
Appendices | One page, sub-headings | "APPENDIX A-D" chapters, listed in Contents

## 4. Front matter

Page | Change
Title page | Department layout: title, "submitted in partial fulfillment...", Submitted By (both names + roll numbers), 7th Semester, Supervised By, logo, department, institute, date
Declaration | Department's academic-honesty text (plural); two signature blocks; DATE and PLACE
Certificate | Logo + department header, supervisor block with email, "To Whom It May Concern", course Project II (EC4201), supervisor signature, Examiners 1-4 (two per row)
Abstract | Group voice, 3 paragraphs
Acknowledgement | Thanks the supervisor, HoD, Director and faculty; signed by both students
Contents | Now lists the front-matter pages and sub-sections (depth 2)
New | LIST OF ABBREVIATIONS (25 terms) and LIST OF SYMBOLS (9 symbols)

## 5. Chapter map (old → new)

Old section | New location
1.1 Background | 1.1 Overview
1.2 Internship Overview | 1.3 Problem Statement and Key Contributions (new work-division table)
1.3 Problem Statement | 1.3 Problem Statement and Key Contributions
1.4 Motivation | 1.2 Sign Language Accessibility and Wearable HUDs
1.5 Objectives, 1.6 Scope | 1.4 Objectives and Scope
(new) | 1.5 Report Organization
2.1 Relevant Concepts | 2.3 Theoretical Background (2.3.1-2.3.4)
2.2 Existing Technologies | 2.1 Existing Approaches and Limitations
2.3 Literature Survey | 2.2 Review of Related Work
2.4 Identified Gap | 2.4 Identified Gap and Technical Requirements
3.1 Overall Workflow | 3.1 Design Methodology and Implementation Flow
3.2 Materials/Tools | 3.2 Hardware and Software Tools
3.3 Design Methodology (sub-parts) | 3.3 Electronics, 3.4 Firmware, 3.5 Optics, 3.6 Enclosure, 3.7 Sign-Recognition Software
3.4 Procedure | 3.8 Integration and Test Procedure
3.5 Week-wise Summary | 3.9 Phase-wise Work Summary
4.1-4.5 Results | 4.1 Bring-Up, 4.2 Electrical, 4.3 Display Timing, 4.4 Optics, 4.5 Enclosure, 4.6 Comparison
Ch. 5 Challenges and Problem-Solving | 4.7 Challenges and Solutions
Ch. 6 Learning Outcomes | Removed (not in the department format)
7.1 Conclusion, 7.2 Key Achievements | 5.1 Conclusion
(new) | 5.2 Limitations and Assumptions
7.3 Future Scope | 5.3 Future Work
Appendices (one page) | Appendix A Wiring and BOM, B Firmware Excerpt, C UDP Interface and Test Tools, D Bring-Up Test Sketches

## 6. Unchanged

- Title of the work, all measured numbers, equations, tables and results.
- All 10 figures (TikZ diagrams and OpenSCAD renders) and the 12 references.
- Short bullet-point style.

## 7. Please confirm

- Course code: Project II (EC4201), 7th Semester (taken from the department's Major Project Report).
- Date: November, 2026.
- Work division: Ayush Verma = sign-recognition software; Charan Tej = hardware, firmware, optics and enclosure (Table 1.1).
- Supervisor designation: Assistant Professor (from rf-ids-report.tex).

## Build

cd docs/report && tectonic main.tex
sh docs/guide/build_pdf.sh        # rebuilds this change log too
