Charan20510/sign_lang_hud_glasses/docs/drawings/hud_glasses_drawings_v1.pdf

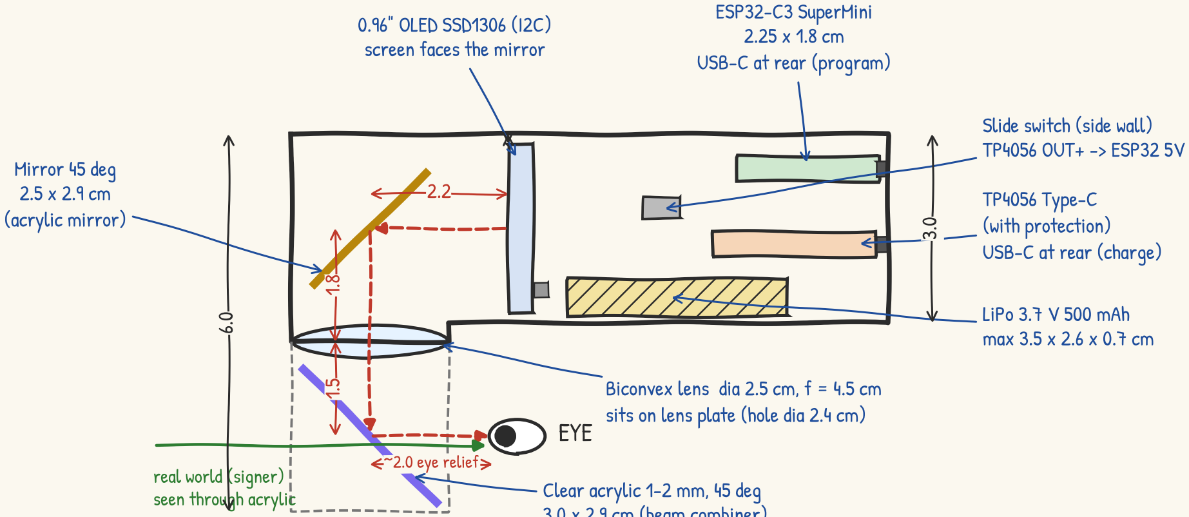
[picture p43: figure]
Mirror 45 deg 2.5 x 2.9 cm (acrylic mirror); 0.96" OLED SSD1306 (I2C) screen faces the mirror; ESP32-C3 SuperMini 2.25 x 1.8 cm USB-C at rear (program); TP4056 Type-C (with protection) USB-C at rear (charge); LiPo 3.7 V 500 mAh max 3.5 x 2.6 x 0.7 cm; Slide switch (side wall) TP4056 OUT+ -> ESP32 5V; Biconvex lens dia 2.5 cm, f = 4.5 cm sits on lens plate (hole dia 2.4 cm); Clear acrylic 1-2 mm, 45 deg; EYE; real world (signer) seen through acrylic; ~2.0 eye relief

open front & back below lens (side panels only)

3.0 x 2.9 cm (beam combiner)

9.5

2.5 (optics head) | 7.0 (electronics tube)

SIDE VIEW (left = front, looking at right eye from outside) width into page = 2.9 cm internal

## Why these distances?

OLED -> mirror = 2.2 cm
mirror -> lens = 1.8 cm
object distance u = 2.2 + 1.8 = 4.0 cm lens focal length f = 4.5 cm (u < f)

1/v = 1/f - 1/u = 1/4.5 - 1/4.0
v = -36 cm (virtual, upright image) magnification = |v/u| = 9x

=> text appears ~38 cm in front of the eye, large and easy to focus

## Build notes

1. Focus tuning: slide OLED +/- 3 mm until text is sharp (keep OLED->lens path < 4.5 cm).
2. Align OLED active-area centre with mirror centre.
3. Paint interior matte black (stops stray glare).
4. Use thin acrylic (1-2 mm) to avoid double image.
5. Two 45 deg reflections: if text looks flipped,
fix in code: display.setRotation(2) / mirror cmd.
6. Material: 3 mm foam board / cardboard (proto), then 3D-printed PLA.
7. Unit clips on glasses arm, head in front of eye.
8. Option: move LiPo to opposite arm for balance.

# Sign-Language HUD Glasses - Display Unit (Side View, to scale)

Sheet 1 of 2 | All dimensions in cm (internal) | Based on June_Glasses layout, adapted for ESP32-C3 + 25 mm / f = 45 mm biconvex lens
Drawn by: Charan | ECE (VLSI), IIIT Manipur | Semester project

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

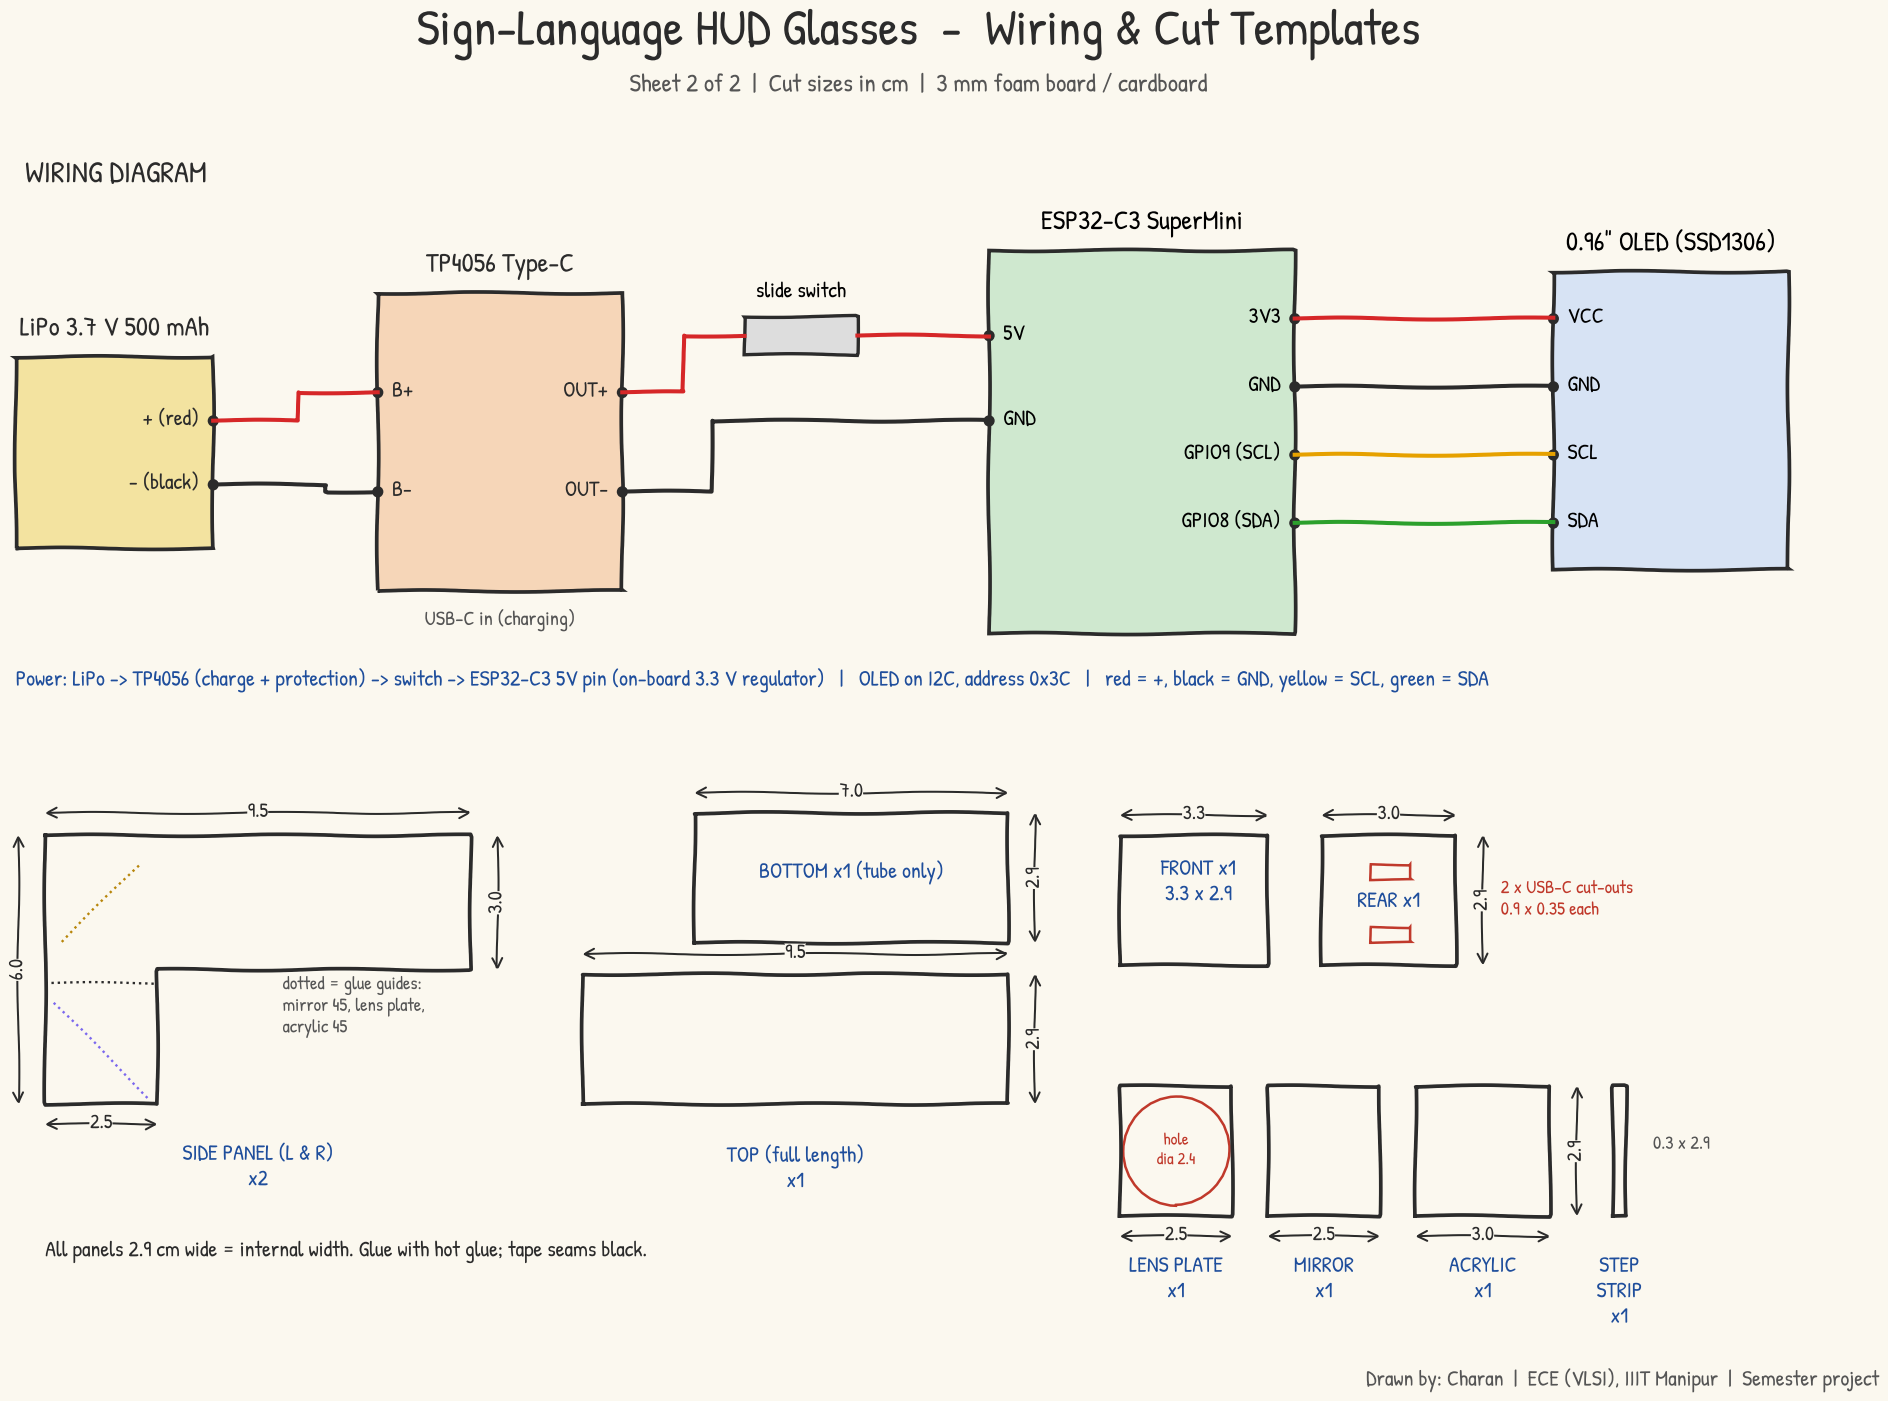
[picture p44: page 2]
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
