Charan20510/sign_lang_hud_glasses/(commit log)

2026-10-15 Phase 1 data + Phase 2 keypoints
    Phase 1:
    - ml/download_include.py: INCLUDE-50 index (with downloaded column), extract
    from local zips when present, fix train/test mix-up for MVI_0060 vs MVI_0060_
    - tools/record_custom.py, tools/data_summary.py, reports/data_summary.csv
    Phase 2:
    - ml/normalize.py: shared landmark layout (149 features) + normalize()
    (shoulder centre/scale, resample to T=32)
    - ml/extract_keypoints.py: MediaPipe Holistic -> one raw .npy per video,
    --check and --plot
    - tests/test_normalize.py
    - 958/958 clips extracted, hands seen in 89.2% of frames
    [data_summary.csv, keypoints_summary.csv]
2026-10-24 Bring-up: breadboard-only Step 2 (friction-fit), soldering moved to final build
2026-10-24 Bring-up: printable PDF guide with step diagrams
2026-10-26 Bring-up: steps 3–6 results, docs update
2026-10-29 Enclosure: parametric OpenSCAD model, STLs, print + assembly guide
    - hud_enclosure.scad: body, lid, lens plate, test-fit parts; collision asserts
    - build.sh exports STL + PNG previews
    - lens->acrylic 16 mm so 30 mm acrylic clears lens plate
    [body.stl, hud_enclosure.scad, lens_plate.stl, lid.stl, test_fit.stl]
2026-10-29 Handoff: enclosure v2 plan (pockets + clip-on mount)
2026-10-29 Bring-up guide: 15 steps, bench-supply LiPo charging
    - Step 8: charge LiPo on bench DC supply (4.20 V, 0.30 A, stop <= 0.05 A); R3 mod kept as optional note
    - Step 9: solder battery leads to B+/B-, tape TP4056 USB "NO USB"
    - Steps 10-14: ESP32 on battery + runtime, leftover checks, optics bench test, soldering, enclosure
    - Checklist synced with md results; LiPo #1 = 3.999 V; parts updated (600 mAh, lens, acrylic in hand)
    - PDF rebuilt (17 pages); handoff + overview updated
2026-10-30 Bring-up: Step 10 runs on battery (READY + IP, 5V pin 3.967 V)
    - Guide: Step 10 marked RUNS, 5V pin = battery voltage note, switch end tabs = mounting only
    - Checklist + md results: battery power row filled (3V3, switch toggle, runtime pending)
    - PDF rebuilt; handoff + overview updated
2026-10-31 Enclosure v3.1: no mirror, measured glasses, print-ready plate
    - OLED flat 22 mm above lens (bench), rail slots u = 19/22/25; acrylic 25 mm below lens
    - Pockets per part, lid clicks, board fingers, dovetail slot + swappable clip
    - Clip from measured temple arm 7x7, dv 10, dh 37, rim 13 (strain 2.2 %)
    - print_all.stl: body, lid, lens plate, clip on one bed (~73 g)
    - Step 1-11 marked done; Step 12 measurement sheet PDF; handoff logs
    [body.stl, clip.stl, hud_enclosure.scad, lens_plate.stl, lid.stl, print_all.stl, test_fit.stl]
2026-10-31 Re-scope repo to hardware/firmware; software moved to friend (S1)
    [data_summary.csv, keypoints_summary.csv]
2026-10-31 Add run guide: app to ESP32 Wi-Fi to OLED
2026-11-01 Camera preview: 720p capture and preview-only white balance
2026-11-01 README: project overview, diagrams, enclosure renders, setup guide
2026-11-01 README: add 6 engineering drawing sheets (v3.1) and v1 concept PDF
    Sources of the numbers on the sheets:
    - hud_enclosure.scad: L 95, H 30, W 29, drop 43, side wall 4, lens plate at -6,
    lens dia 25, OLED slots u = 19/22/25, acrylic 30 x 30 x 1, glasses 7x7 / dv 10 / dh 37 / rim 13
    - scad echo: eye level 30 below tube floor, strain 2.2 %, jaw_drop 35, jaw_out 12.5, rim 14.6
    - STL bounding boxes: body 99.8 x 77.8 x 33, lid 24.1 thick, lens plate 29.8 x 30.4 x 3,
    clip 25.9 x 45 x 25, print_all 136.6 x 160.6
    - hardware/enclosure/README.md: masses, print times, print settings
    - docs/hardware_bringup.md: 5.162 V, 3.302 V, 3.999 V, 3.967 V
    - glasses_display.ino / software/run.py: 60 px/s, 2 pass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
